TadAtThayer/MazeController/README.md

# MazeController
Arduino Shield for ES28 project
