TadAtThayer/MazeController/3d_models/LSF0102DQER.step

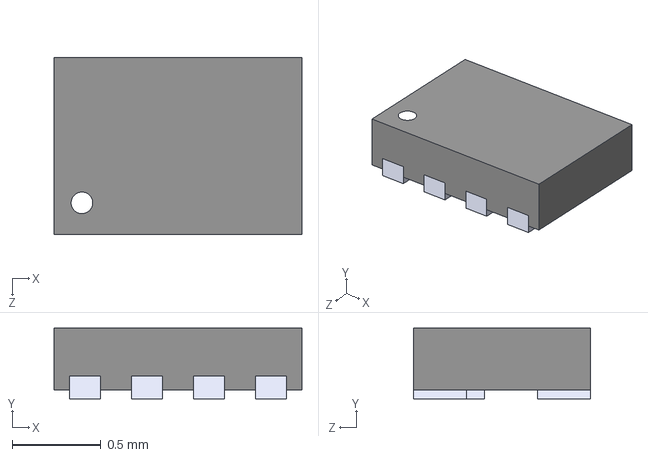
[picture p1: CAD file, 2023-10-11]
3d_models/LSF0102DQER.step
1.40 x 0.4 x 1.00 mm
