TadAtThayer/MazeController/ConnectorBoard/WiringHarness/WiringHarness.step

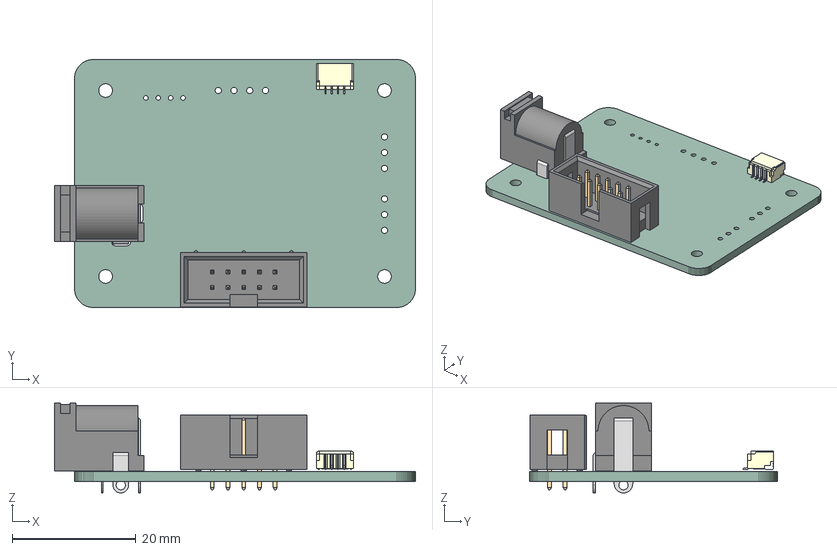
[picture p2: CAD file, 2023-10-23]
ConnectorBoard/WiringHarness/WiringHarness.step
58.2 x 40.0 x 14.5 mm
WiringHarness PCB
