TadAtThayer/MazeController/CUI_DEVICES_PJ-002A.step

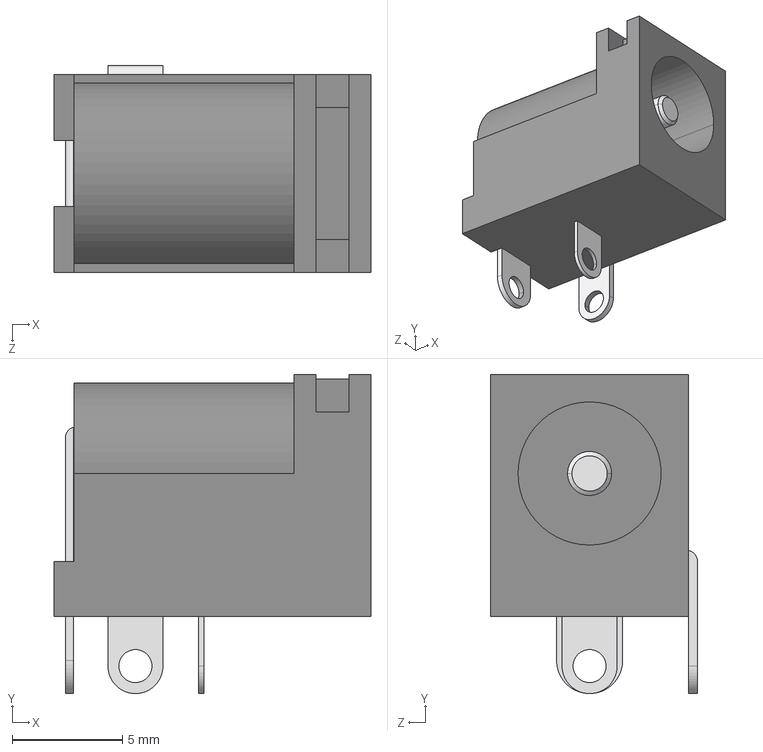
[picture p3: CAD file, 2023-10-09]
CUI_DEVICES_PJ-002A.step
14.4 x 14.5 x 9.40 mm
