TadAtThayer/MazeController/3d_models/COM-09032.step

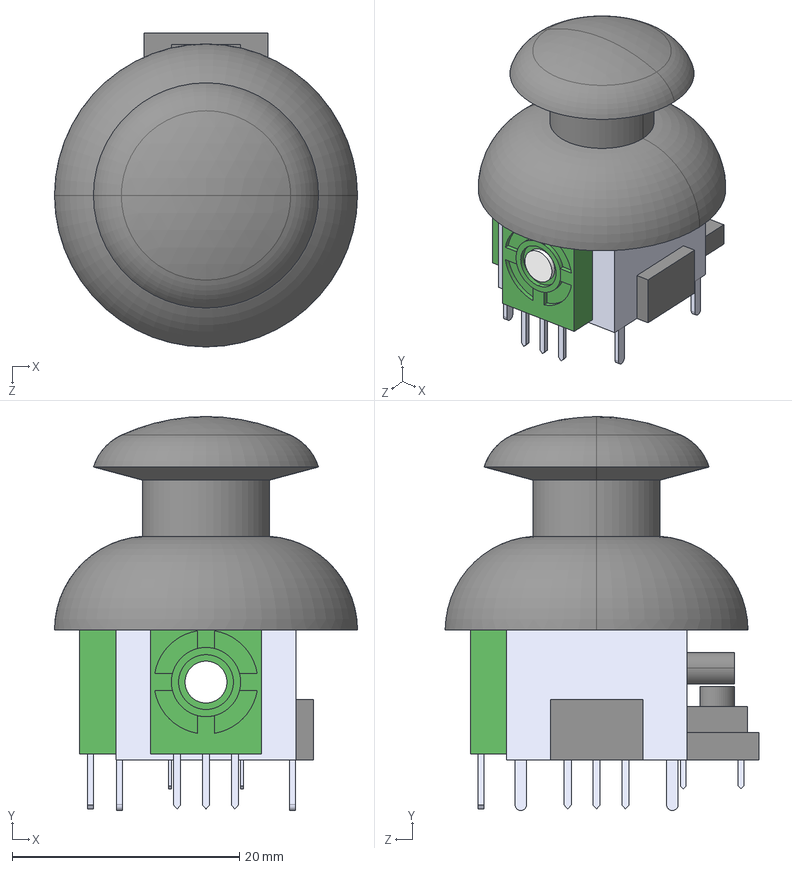
[picture p4: CAD file, 2023-10-11]
3d_models/COM-09032.step
26.7 x 34.7 x 27.6 mm
