TadAtThayer/MazeController/3d_models/c-5104340-01-b-3d.stp

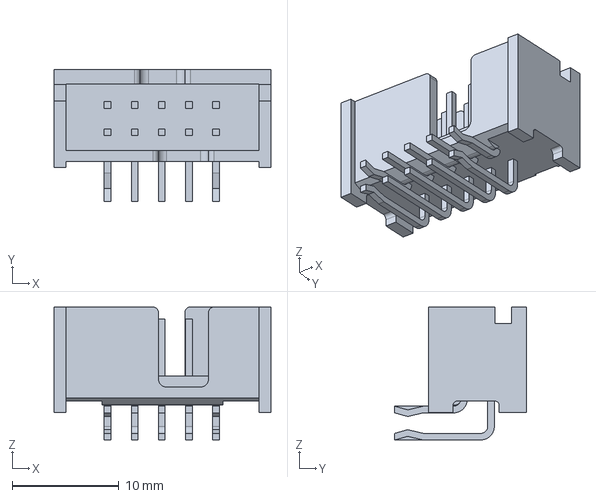
[picture p5: CAD file, 2023-10-10]
3d_models/c-5104340-01-b-3d.stp
20.3 x 12.3 x 12.5 mm
