TadAtThayer/MazeController/3d_models/61201021621.step

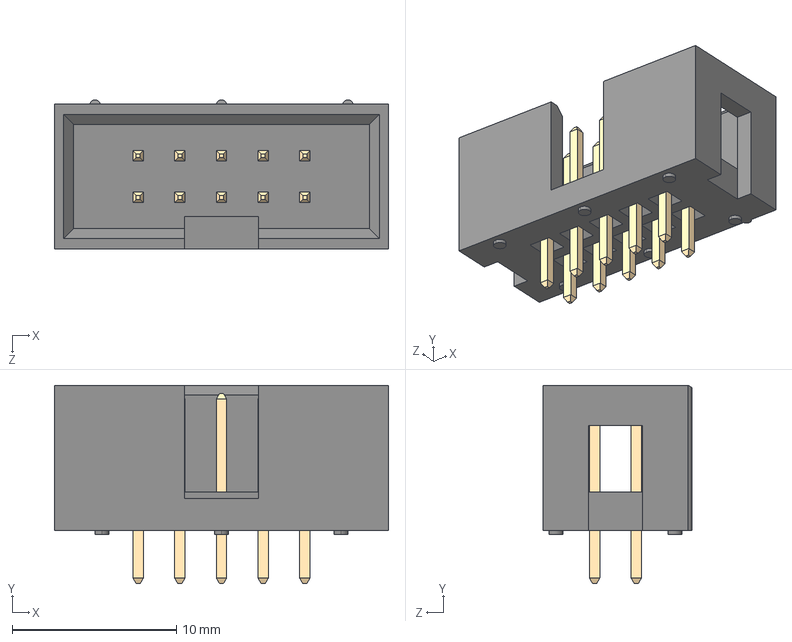
[picture p6: CAD file, 2023-10-09]
3d_models/61201021621.step
20.4 x 12.1 x 9.10 mm
