TadAtThayer/MazeController/(threads)

Thread 1 (2023-10-11):

Remove LDO for Arduino

tadtruex, 2023-10-11:
Remove the 5V LDO on the supply to the Arduino.

Replace with Schottky diode to mimic the power connector on Uno R3

Closed 2023-10-31.

Thread 3 (2023-10-11):

Features of Controller Board

tadtruex, 2023-10-11:
This is sort of a tracking list for what might go on the main board...

- [x] Joystick
- [x] Ribbon Cable connector
- [x] Accelerometer
- [ ] LED backpack (maybe on Wiring Harness instead)
- [x] Discrete LEDs
- [ ] Buzzer
- [x] Reset Button
- [x] Probe points for PWM checking

Add tracking issues for each of these (attached to Initial Public Release milestone) if they are included.

tadtruex, 2023-10-31:
Backpack moved to wiring harness.
Buzzer moved to the "what was I thinking" bucket.

Closed 2023-10-31.

Thread 4 (2023-10-16):

Fix Servo connections

tadtruex, 2023-10-16:
Mechanical samples are at 50mil pitch, should be 100mil.

Thread 5 (2023-10-16):

Add display to carrier board

tadtruex, 2023-10-16:
Add a display to either the carrier board or the joystick board.

Also add some LEDS...

If it ends up on the carrier board, may want to add another LDO to power it.

Closed 2023-10-31.

Thread 12 (2023-11-14):

Power supply issues

tadtruex, 2023-11-14:
Looks like we have some serious PS issues.

When the system powers up, it draws around 1 amp at 9V.  This is with 200uF of bulk cap added.  The initial transient is likely charging the caps, not really the motors.

The motors themselves seem to trip the benchtop supply around 1A @ 9V.  Motor voltage is set to ~5.5.

Possible solutions

- [x] Lots more DCap on the connector board.
- [ ] Slower Reset rise time (more cap on controller board)
- [ ] potentially add a power/reset controller to the controller board.

tadtruex, 2023-11-21:
Fixed as of effb6eae01d

Closed 2023-11-21.

Thread 13 (2023-11-14):

Move Green LED

tadtruex, 2023-11-14:
The green LED sits directly on top of the USB jack and shorts to it.

Move it outward or make it a SMD.

Closed 2023-11-21.

Thread 6 (2023-11-14):

Regulator bias network wrong

tadtruex, 2023-11-14:
The biasing network on the regulator is mostly upside down...

R3 and R4 are backward, and the pot really ought to be in the middle with the wiper connected to the reference pin.

Closed 2023-11-20.

Thread 16 (2023-11-29):

Additional power wires

tadtruex, 2023-11-29:

tadtruex, 2023-11-29:
This is optional as it is easy enough to bridge at the connector.

tadtruex, 2024-01-16:
Not fixing.  Switch to stepper made this moot.

Closed 2024-01-16.

Thread 17 (2023-12-27):

Change motors

tadtruex, 2023-12-27:
This will be a fairly invasive change...

It looks like standard stepper motors have some pretty inconvenient behaviors when loaded.  In particular, because they seem to implement a P type controller, when they get where they are going, they relax, causing the maze to fall, causing the motor to apply torque...  Oscillations.

Looking now at switching to small steppers (2 or possibly 3 if we need to drive both sides of the outer frame).  The cheapo ones come with a ULN2003 driver, which is really just 7 darlington pairs in a 16 pin DIP.  We'd rather present a higher level interface (step/direction might be ideal) so, tentatively thinking of parking an stm32011f6p6 on the board to present stepx, stepy, dirx, diry.

The board will should accomodate running a second y motor in reverse.

Closed 2024-01-24.

Thread 18 (2024-01-16):

10K Pot

tadtruex, 2024-01-16:

tadtruex, 2024-01-16:
Currently have a 1K pot on the adjustable reg.  Probably ought to make this 10K.  We plan to provide ~1.2A, so probably doesn't really matter, but kinda tacky to burn 25mW just on the reg.

Thread 19 (2024-01-16):

Wrong LDL regulator

tadtruex, 2024-01-16:
The 3.3V regulator has the wrong part number.  The part speced is adjustable.  The proper part number is

497-19548-1-ND (LDL212PV33R).

Same footprint.

Closed 2024-01-16.

Thread 20 (2024-01-17):

PCA9306 Footprint is ridiculous

tadtruex, 2024-01-17:
The footprint used (MSOP-8_3x3mm_P0.65mm) is way too big.  It works, but is really inefficient.

Thread 22 (2024-01-24):

Tracking Issue / Feature List

tadtruex, 2024-01-24:
What are we doing here?

We need either a step/direction interface or a PWM version.  PWM will need a way to reset zero since there is no feedback and we are really just mimicking servos.  Start with step/dir.

Minimum Requirements
- [ ] Step/Dir interface
- [ ] Manufacturing test
- [ ] I2C interface (mostly for ease of testing)

Enhanchements
- [ ] PWM
- [ ] I2C user interface

Future Board Mods if we do another spin
- [ ] Programmable POT for motor supply
- [ ] Heatsink on Motor Reg.
- [ ] Reset button
- [ ] Power Switch
- [ ] Isolate Motor supply from Arduino so we don't burn out too many Arduino regulators.

Thread 23 (2024-01-24):

Step/Dir interface

tadtruex, 2024-01-24:

tadtruex, 2024-01-24:
Dir = Low (Forward)
Dir = High (Reverse)
Step = Rising edge detect.

Steps can arrive at any rate, however the motor only responds at ~1Khz.

Thread 32 (2024-01-24):

Isolate Motor supply from Arduino so we don't burn out too many Arduino regulators.

tadtruex, 2024-01-24:

tadtruex, 2024-02-02:
Duplicate of #37

Closed 2024-02-02.

Thread 33 (2024-01-24):

Motor Saver

tadtruex, 2024-01-24:
Need to turn off the motor coils if the maze sits idle for too long.  They draw a decent amount of current (1.2A total) and the regulator gets pretty warm (hot) to the touch.

There "should" be enough static friction that we can just turn off the motor and stay put, but as a backup, we could pulse the coils periodically.

tadtruex, 2024-01-30:
Added a 10 second idle shutoff to each motor.  May need to revisit if we need to pulse the coils to provide some holding torque.

Commit 51164a1 contains the fix.

Closed 2024-01-30.

Thread 34 (2024-01-30):

Motor tracking

tadtruex, 2024-01-30:
The y motors aren't tracking each other correctly.  Seems to be repeatable with different motors, so either there is an even mix of fast and slow motors (and I got unlucky testing) or there is a code issue.

Thread 35 (2024-01-31):

5V I2C on JST connector is broken

tadtruex, 2024-01-31:
The solder jumpers on the back side were intended to allow us to run I2C over a QWIIC connector a 5V by default.

Unfortunately, this shorts the 3.3V regulator to 5V and runs the processor at 5 instead of 3.3.

JP1 must be cut on ALL builds of this rev.  Best recommendation is to ditch the QWIIC connector and its support circuitry entirely.

Thread 37 (2024-02-02):

Run motors directly from the brick

tadtruex, 2024-02-02:
On the wiring harness.  Power the motor regulator directly from the brick, not from Vsys.

This will prevent students from accidentally trying to power all three motors from the tiny little LDO on the Arduino.
