TadAtThayer/MazeController/ConnectorBoard/WiringHarness/WiringHarness.kicad_pcb

## KiCad design ConnectorBoard/WiringHarness/WiringHarness.kicad_pcb (2024-01-19)

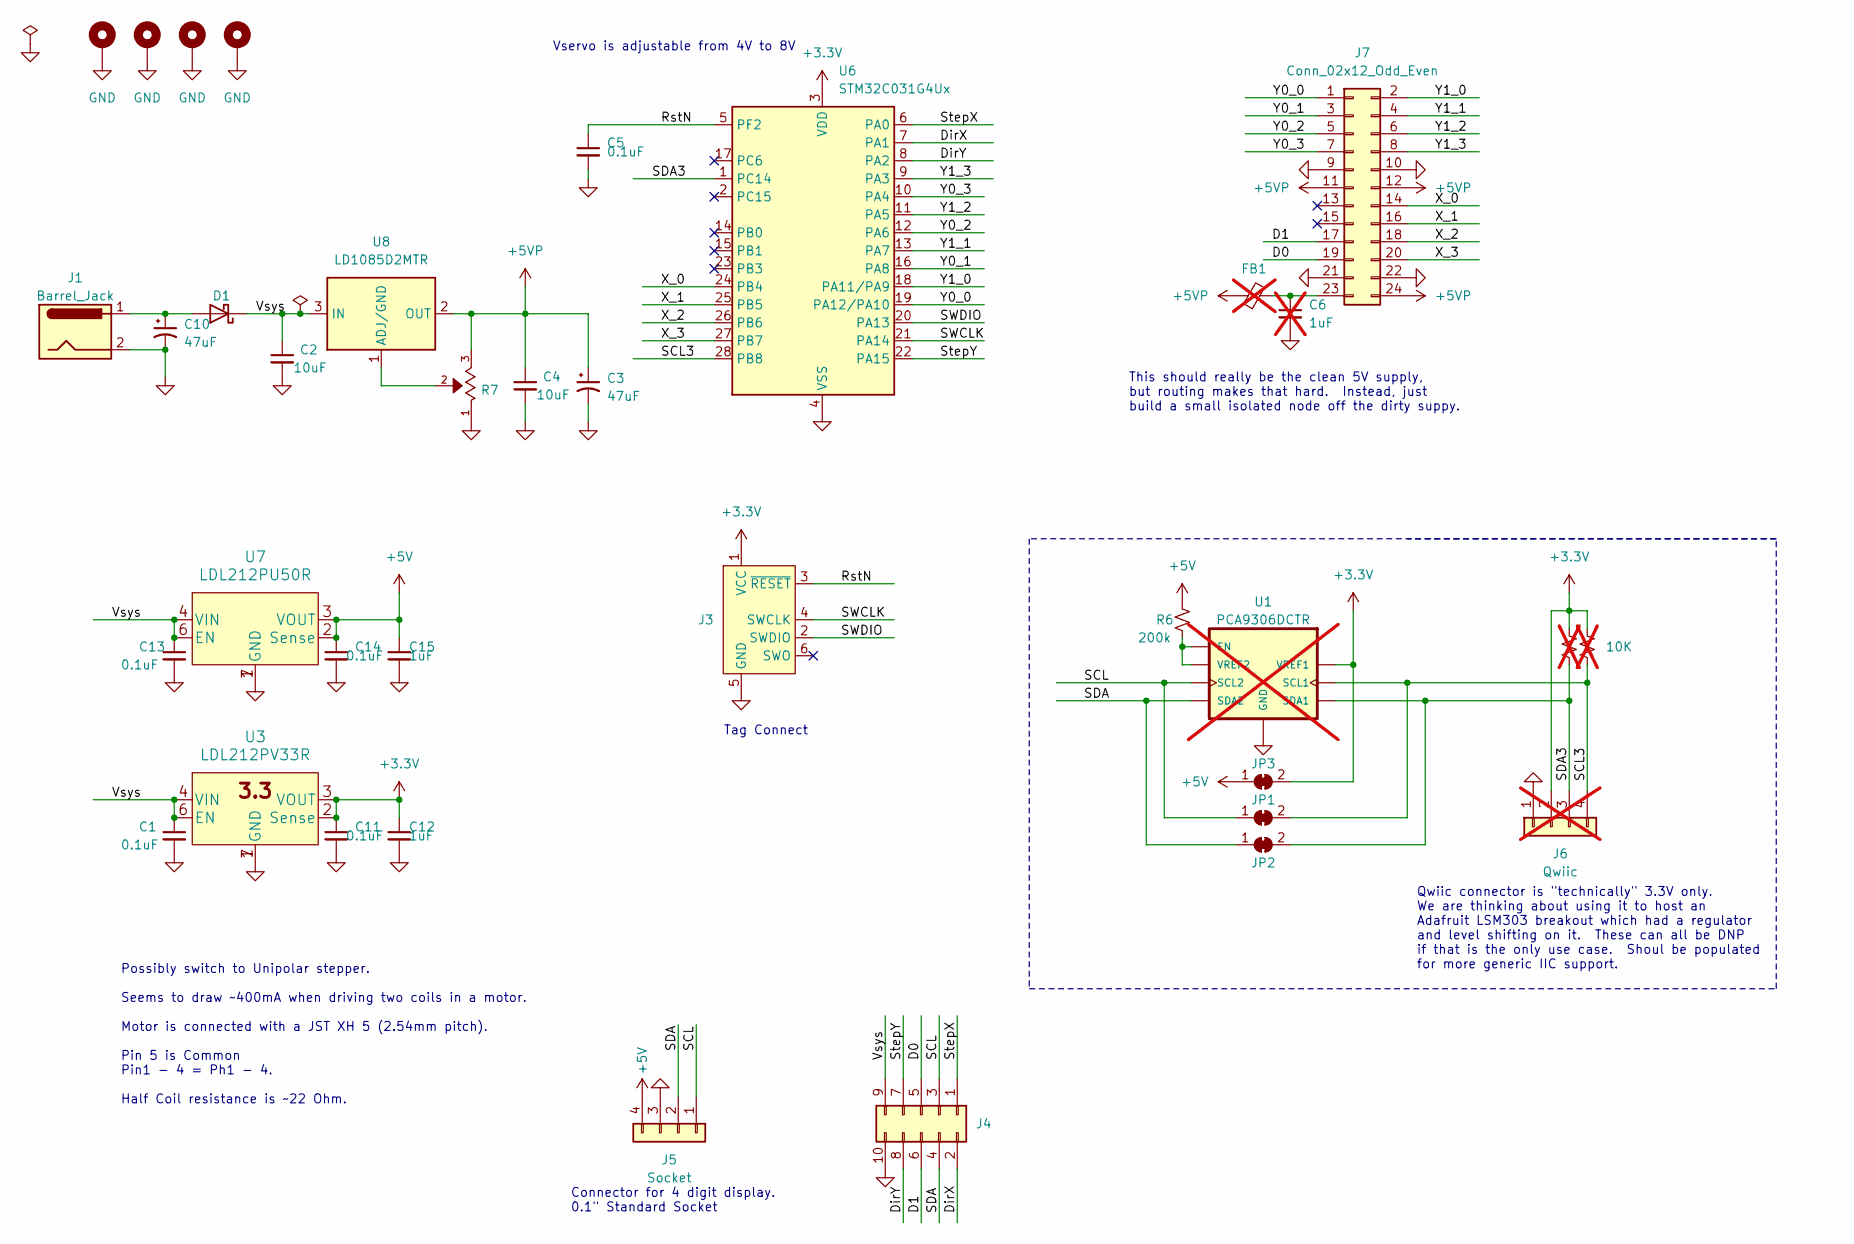
[picture p7: schematic WiringHarness.kicad_sch]

Parts:
C1, C5, C11, C13, C14: 0.1uF; C_0603_1608Metric; Digikey 1276-1861-1-ND
C2, C4: 10uF; C_0805_2012Metric; Digikey 490-10500-1-ND
C3, C10: 47uF; CP_Radial_D6.3mm_P2.50mm; Digikey 10-ECE-A1EKA470ICT-ND
C6: C_1U; C_0603_1608Metric; MPN CL10B105KA8NFNC; DigiKey PN 1276-1942-1-ND; not fitted
C12, C15: 1uF; C_0603_1608Metric; Digikey 1276-1861-1-ND
D1: D_Schottky; D_SMA; Digikey SK36A-LTPMSCT-ND
FB1: FB_120_100MHz; L_0603_1608Metric; DigiKey PN 490-16660-1-ND; not fitted
H1, H2, H3, H5: MountingHole_Pad; MountingHole_2.2mm_M2_Pad
J1: Barrel_Jack; BarrelJack_Horizontal; Digikey CP-002A-ND
J3: Conn_ARM_SWD_TagConnect_TC2030-NL; Tag-Connect_TC2030-IDC-NL_2x03_P1.27mm_Vertical
J4: Conn_02x05_Odd_Even; PinHeader_2x05_P2.54mm_Vertical; Digikey 732-2094-ND
J5: Socket; PinSocket_1x04_P2.54mm_Vertical; Digikey S7037-ND
J6: Qwiic; JST_SH_SM04B-SRSS-TB_1x04-1MP_P1.00mm_Horizontal; Digikey SM04B-SRSS-TB; not fitted
J7: Conn_02x12_Odd_Even; PinHeader_2x12_P2.54mm_Horizontal; Digikey 2057-PH2RA-24-UA-ND
JP1, JP2, JP3: SolderJumper_2_Bridged; SolderJumper-2_P1.3mm_Bridged_RoundedPad1.0x1.5mm
R1, R2: 10K; R_0603_1608Metric; Digikey RMCF0603FT10K0CT-ND; not fitted
R6: 200k; R_0603_1608Metric; Digikey RMCF0603FT200KCT-ND
R7: TC33X-2-102E; TRIM_TC33X-2-201E; Digikey TC33X-103ECT-ND
U1: PCA9306DCTR; MSOP-8_3x3mm_P0.65mm; Digikey 296-18509-1-ND; not fitted
U3: LDL212PV33R; LDL212_2x2mm_Pitch0.5mm; Digikey 497-19548-1-ND
U6: STM32C031G4Ux; QFN-28_4x4mm_P0.5mm; Digikey 497-STM32C031G6U6-ND
U7: LDL212PU50R; LDL212_3x3mm_Pitch0.95mm; Digikey 497-16897-1-ND
U8: LD1085D2MTR; TO-263-3_TabPin2; Digikey 497-3419-1-ND

Connections:
+3.3V: C11.1, C12.1, J3.1 (VCC), J6.2, JP3.2 (B), R1.1, R2.1, U1.2 (VREF1), U3.2 (Sense), U3.3 (VOUT), U6.3 (VDD)
+5V: C14.1, C15.1, J5.4, JP3.1 (A), R6.1, U7.2 (Sense), U7.3 (VOUT)
+5VP: C3.1, C4.1, FB1.1, J7.11, J7.12, J7.24, R7.3, U8.2 (OUT)
/D0: J4.5, J7.19
/D1: J4.6, J7.17
/DirX: J4.2, U6.7 (PA1)
/DirY: J4.8, U6.8 (PA2)
/RstN: C5.1, J3.3 (~RESET), U6.5 (PF2)
/SCL: J4.3, J5.1, JP1.1 (A), U1.6 (SCL2)
/SCL3: J6.4, JP1.2 (B), R1.2, U1.3 (SCL1), U6.28 (PB8)
/SDA: J4.4, J5.2, JP2.1 (A), U1.5 (SDA2)
/SDA3: J6.3, JP2.2 (B), R2.2, U1.4 (SDA1), U6.1 (PC14)
/SWCLK: J3.4 (SWCLK), U6.21 (PA14)
/SWDIO: J3.2 (SWDIO), U6.20 (PA13)
/StepX: J4.1, U6.6 (PA0)
/StepY: J4.7, U6.22 (PA15)
/Vsys: C1.1, C2.1, C13.1, D1.1 (K), J4.9, U3.4 (VIN), U3.6 (EN), U7.4 (VIN), U7.6 (EN), U8.3 (IN)
/X_0: J7.14, U6.24 (PB4)
/X_1: J7.16, U6.25 (PB5)
/X_2: J7.18, U6.26 (PB6)
/X_3: J7.20, U6.27 (PB7)
/Y0_0: J7.1, U6.19 (PA12/PA10)
/Y0_1: J7.3, U6.16 (PA8)
/Y0_2: J7.5, U6.12 (PA6)
/Y0_3: J7.7, U6.10 (PA4)
/Y1_0: J7.2, U6.18 (PA11/PA9)
/Y1_1: J7.4, U6.13 (PA7)
/Y1_2: J7.6, U6.11 (PA5)
/Y1_3: J7.8, U6.9 (PA3)
GND: C1.2, C2.2, C3.2, C4.2, C5.2, C6.2, C10.2, C11.2, C12.2, C13.2, C14.2, C15.2, H1.1, H2.1, H3.1, H5.1, J1.2, J3.5 (GND), J4.10, J5.3, J6.1, J7.9, J7.10, J7.21, J7.22, R7.1, U1.1 (GND), U3.1 (GND), U3.7 (GND), U6.4 (VSS), U7.1 (GND), U7.7 (GND)
unnamed: C10.1, D1.2 (A), J1.1
unnamed: C6.1, FB1.2, J7.23
unnamed: R6.2, U1.7 (VREF2), U1.8 (EN)
unnamed: R7.2, U8.1 (ADJ/GND)

Notes on the sheet:
This should really be the clean 5V supply, but routing makes that hard. Instead, just build a small isolated node off the dirty suppy.
Connector for 4 digit display. 0.1" Standard Socket
Vservo is adjustable from 4V to 8V
Possibly switch to Unipolar stepper. Seems to draw ~400mA when driving two coils in a motor. Motor is connected with a JST XH 5 (2.54mm pitch). Pin 5 is Common Pin1 - 4 = Ph1 - 4. Half Coil resistance is ~22 Ohm.
Qwiic connector is "technically" 3.3V only. We are thinking about using it to host an Adafruit LSM303 breakout which had a regulator and level shifting on it. These can all be DNP if that is the only use case. Shoul be populated for more generic IIC support.
Tag Connect

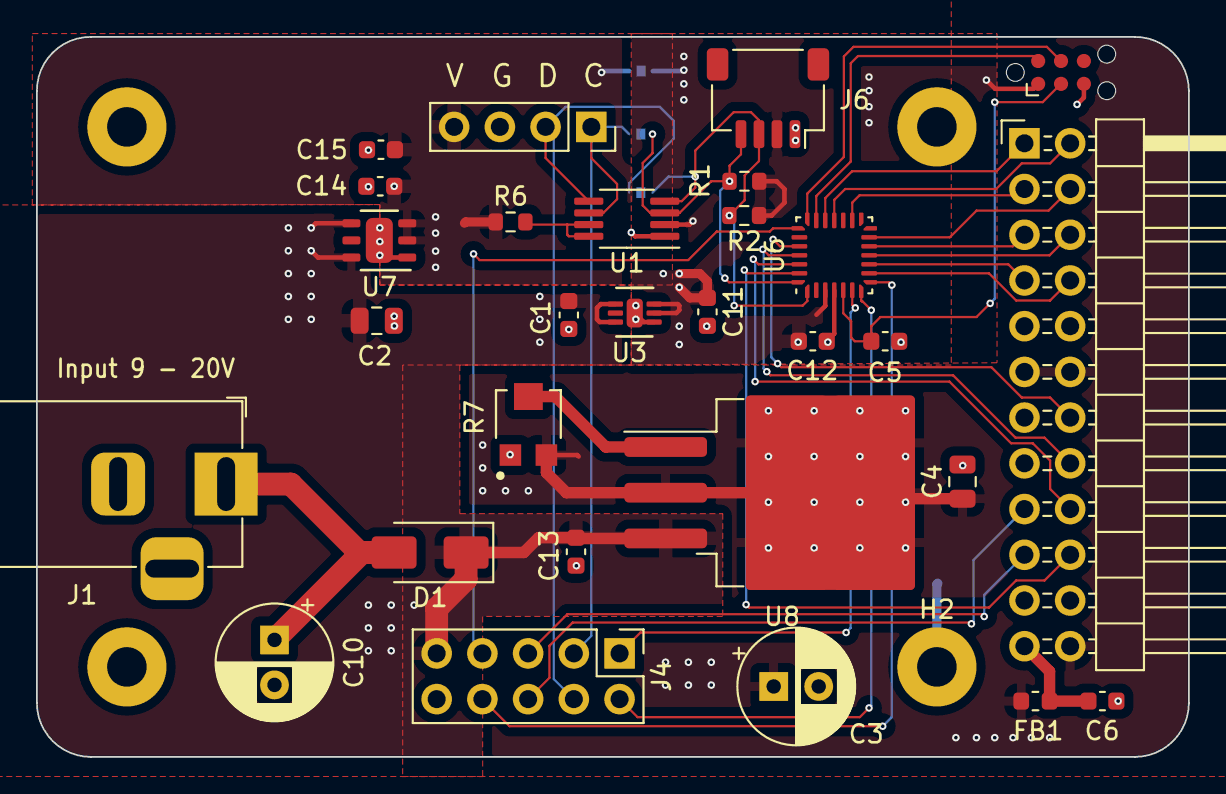
[picture p8: board WiringHarness.kicad_pcb from above]

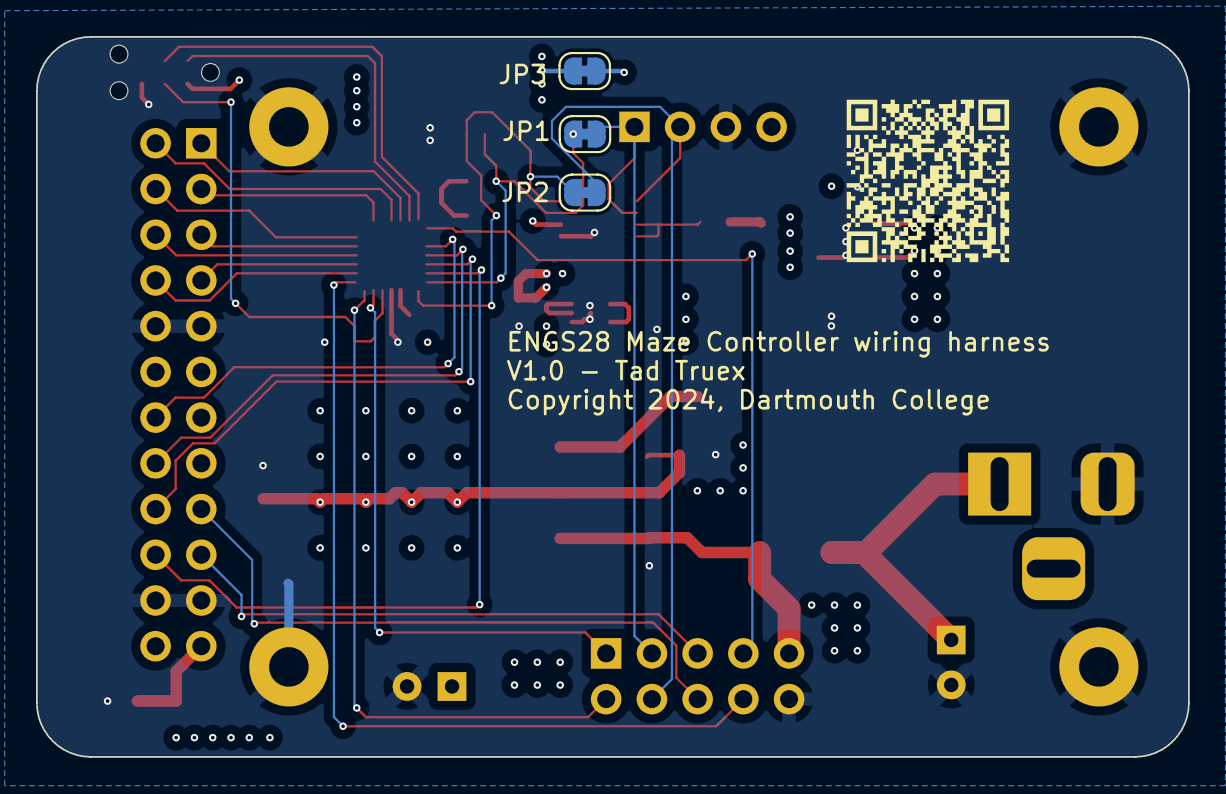
[picture p9: board WiringHarness.kicad_pcb from below]

Board: 4 copper layers, 64.0 x 40.0 mm, 36 parts (3 on the bottom side), 34 nets.
