TadAtThayer/MazeController/ControllerShield/ControllerShield.kicad_pcb

## KiCad design ControllerShield/ControllerShield.kicad_pcb (2024-01-05)

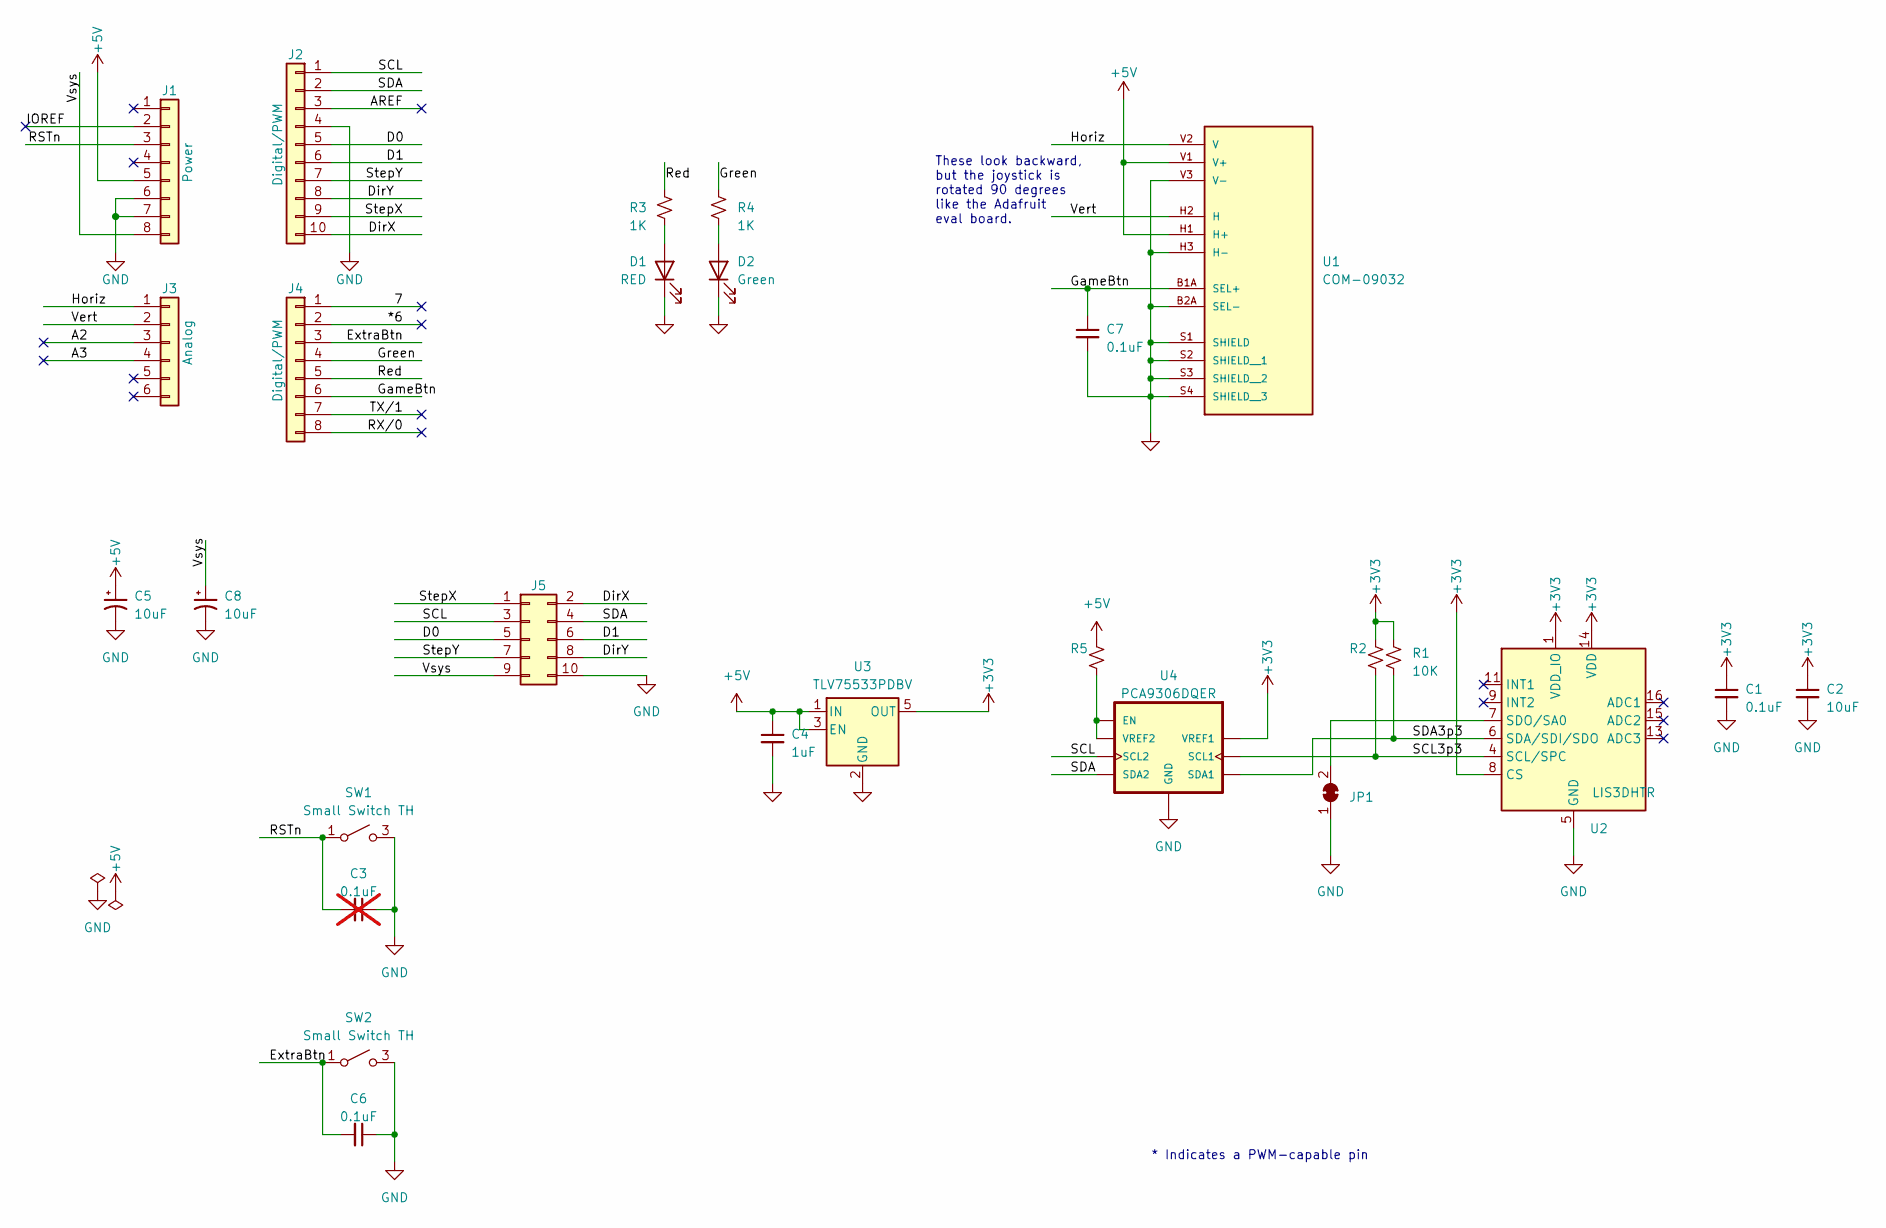
[picture p10: schematic ControllerShield.kicad_sch]

Parts:
C1, C6, C7: 0.1uF; C_0603_1608Metric; Digikey 1276-1000-1-ND
C2: 10uF; C_0603_1608Metric; Digikey 490-GRM188R61E106KA73JCT-ND
C3: 0.1uF; C_0603_1608Metric; Digikey 1276-1000-1-ND; not fitted
C4: 1uF; C_0603_1608Metric
C5, C8: 10uF; CP_Radial_D6.3mm_P2.50mm
D1: RED; LED_D5.0mm; Digikey 1125-1188-ND
D2: Green; LED_D5.0mm; Digikey 1125-1184-ND
J1: Power; PinSocket_1x08_P2.54mm_Vertical
J2: Digital/PWM; PinSocket_1x10_P2.54mm_Vertical
J3: Analog; PinSocket_1x06_P2.54mm_Vertical
J4: Digital/PWM; PinSocket_1x08_P2.54mm_Vertical
J5: Conn_02x05_Odd_Even; PinHeader_2x05_P2.54mm_Vertical; Digikey 732-2094-ND
JP1: SolderJumper_2_Bridged; SolderJumper-2_P1.3mm_Bridged_RoundedPad1.0x1.5mm
R1, R2: 10K; R_0603_1608Metric; Digikey RMCF0603FT10K0CT-ND
R3, R4: 1K; R_0603_1608Metric; Digikey RMCF0603FT1K00CT-ND
R5: 200K; R_0603_1608Metric; Digikey RMCF0603FT10K0CT-ND
SW1, SW2: Small Switch TH; SW4_1825910-B_TEC; Digikey 450-1650-ND
U1: COM-09032; XDCR_COM-09032
U2: LIS3DHTR; LGA-16_3x3mm_P0.5mm_LayoutBorder3x5y; Digikey 497-10613-1-ND
U3: TLV75533PDBV; SOT-23-5; Digikey 296-50411-1-ND
U4: PCA9306DQER; TSSOP-8_3x3mm_P0.65mm; DigiKey 296-18509-2-ND

Connections:
+3V3: C1.1, C2.1, R1.1, R2.1, U2.1 (VDD_IO), U2.8 (CS), U2.14 (VDD), U3.5 (OUT), U4.2 (VREF1)
+5V: C4.1, C5.1, J1.5, R5.1, U1.H1 (H+), U1.V1 (V+), U3.1 (IN), U3.3 (EN)
/7: J4.1
/*6: J4.2
/A2: J3.3
/A3: J3.4
/AREF: J2.3
/D0: J2.5, J5.5
/D1: J2.6, J5.6
/DirX: J2.10, J5.2
/DirY: J2.8, J5.8
/ExtraBtn: C6.2, J4.3, SW2.1 (A), SW2.2 (A)
/GameBtn: C7.1, J4.6, U1.B1A (SEL+)
/Green: J4.4, R4.1
/Horiz: J3.1, U1.V2 (V)
/IOREF: J1.2
/RSTn: C3.2, J1.3, SW1.1 (A), SW1.2 (A)
/RX/0: J4.8
/Red: J4.5, R3.1
/SCL: J2.1, J5.3, U4.6 (SCL2)
/SCL3p3: R2.2, U2.4 (SCL/SPC), U4.3 (SCL1)
/SDA: J2.2, J5.4, U4.5 (SDA2)
/SDA3p3: R1.2, U2.6 (SDA/SDI/SDO), U4.4 (SDA1)
/StepX: J2.9, J5.1
/StepY: J2.7, J5.7
/TX/1: J4.7
/Vert: J3.2, U1.H2 (H)
/Vsys: C8.1, J1.8, J5.9
GND: C1.2, C2.2, C3.1, C4.2, C5.2, C6.1, C7.2, C8.2, D1.1 (K), D2.1 (K), J1.6, J1.7, J2.4, J5.10, JP1.1 (A), SW1.3 (B), SW1.4 (B), SW2.3 (B), SW2.4 (B), U1.B2A (SEL-), U1.H3 (H-), U1.S1 (SHIELD), U1.S2 (SHIELD__1), U1.S3 (SHIELD__2), U1.S4 (SHIELD__3), U1.V3 (V-), U2.5 (GND), U2.10 (GND), U2.12 (GND), U3.2 (GND), U4.1 (GND)
unnamed: D1.2 (A), R3.2
unnamed: D2.2 (A), R4.2
unnamed: JP1.2 (B), U2.7 (SDO/SA0)
unnamed: R5.2, U4.7 (VREF2), U4.8 (EN)

Notes on the sheet:
These look backward, but the joystick is rotated 90 degrees like the Adafruit eval board.
* Indicates a PWM-capable pin

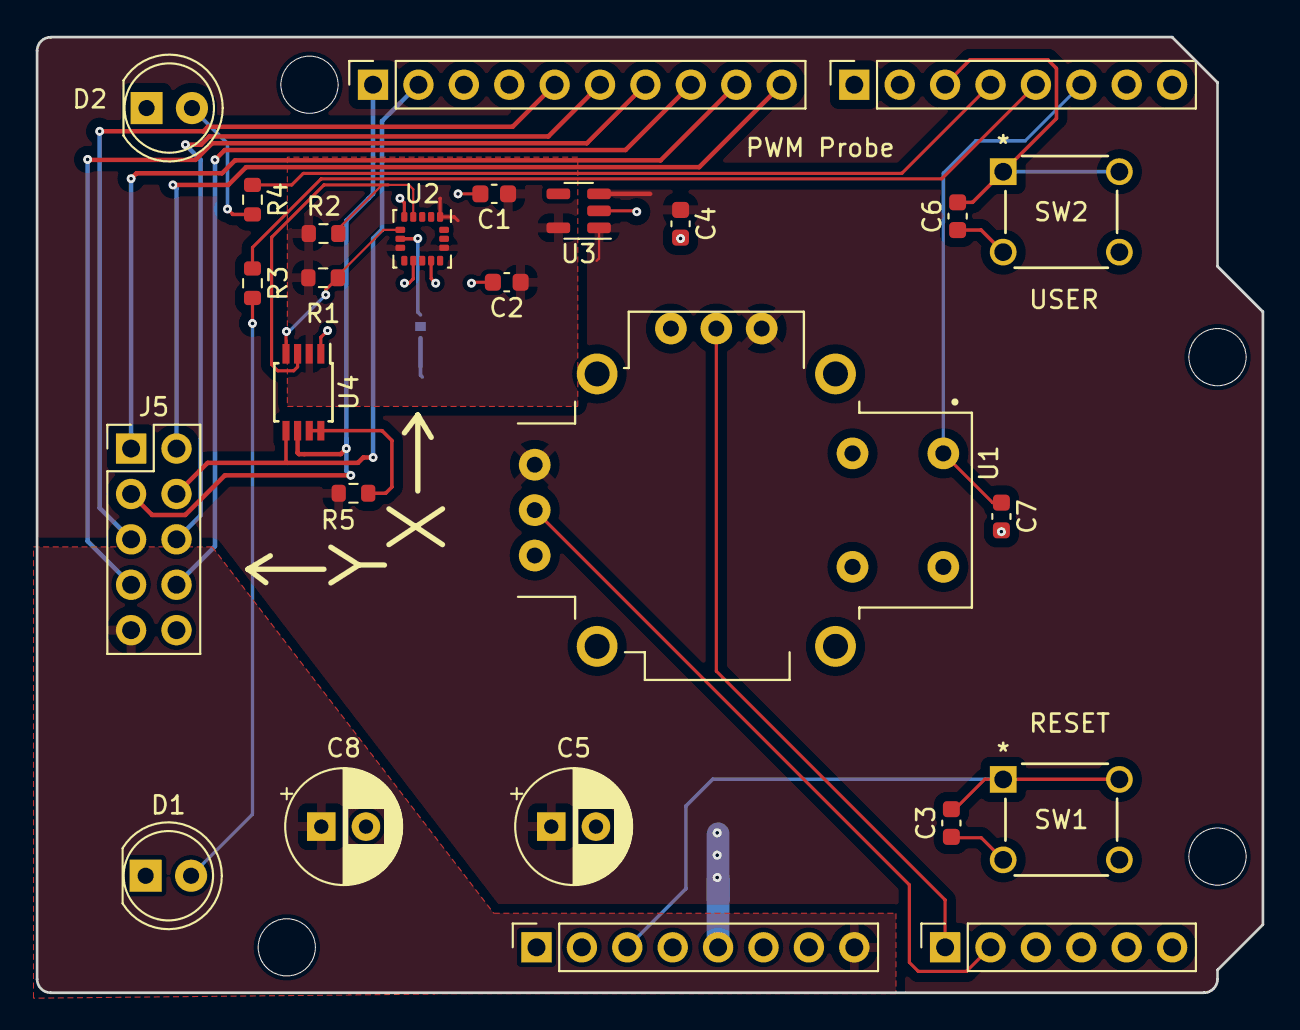
[picture p11: board ControllerShield.kicad_pcb from above]

Board: 2 copper layers, 68.6 x 53.5 mm, 31 parts (1 on the bottom side), 25 nets.

Other parts of the board:
MH1, MH2, MH3, MH4: MountingHole_3.2mm
