TadAtThayer/MazeController/Code/Workspace/StepperDevBoard/StepperDevBoard.ioc

Mcu.UserName=STM32C031C6Tx
PA0.GPIO_Label=StepX
PA0.Signal=S_TIM16_CH1
PA1.GPIO_Label=DirX
PA1.Signal=GPIO_Input
PA10.GPIO_Label=Y0_0
PA10.Signal=GPIO_Output
PA13.GPIO_Label=SWDIO
PA13.Signal=DEBUG_SWDIO
PA14-BOOT0.GPIO_Label=SWCLK
PA14-BOOT0.Signal=DEBUG_SWCLK
PA15.GPIO_Label=StepY
PA15.Signal=GPXTI15
PA2.GPIO_Label=DirY
PA2.Signal=GPIO_Input
PA3.GPIO_Label=Y1_3
PA3.Signal=GPIO_Output
PA4.GPIO_Label=Y0_3
PA4.Signal=GPIO_Output
PA5.GPIO_Label=Y1_2
PA5.Signal=GPIO_Output
PA6.GPIO_Label=Y0_2
PA6.Signal=GPIO_Output
PA7.GPIO_Label=Y1_1
PA7.Signal=GPIO_Output
PA8.GPIO_Label=Y0_1
PA8.Signal=GPIO_Output
PA9.GPIO_Label=Y1_0
PA9.Signal=GPIO_Output
PB0.GPIO_Label=ClockOut
PB0.Signal=GPIO_Output
PB4.GPIO_Label=X_0
PB4.Signal=GPIO_Output
PB5.GPIO_Label=X_1
PB5.Signal=GPIO_Output
PB6.GPIO_Label=X_2
PB6.Signal=GPIO_Output
PB7.GPIO_Label=X_3
PB7.Signal=GPIO_Output
PB8.Signal=I2C1_SCL
PB9.Signal=I2C1_SDA
PC13.GPIO_Label=User Button
PC13.Signal=GPXTI13
