TadAtThayer/MazeController/(commit log)

2023-10-06 start wiring harness
    [WiringHarness.kicad_pcb, WiringHarness.kicad_sch]
2023-10-09 Wiring harness probably OK
    [61201021621.step, CUI_DEVICES_PJ-002A.step, WiringHarness.kicad_pcb, WiringHarness.kicad_sch, WiringHarness.step]
2023-10-10 Add right angle ribbon cable to wiring harness
    [WiringHarness.kicad_pcb, WiringHarness.kicad_sch, WiringHarness.step, c-5104340-01-b-3d.stp]
2023-10-10 Rounded corners and version string
    [WiringHarness.kicad_pcb, WiringHarness.kicad_sch]
2023-10-10 Add QR code
    [WiringHarness-B_Cu.gbr, WiringHarness-B_Mask.gbr, WiringHarness-B_Paste.gbr, WiringHarness-B_Silkscreen.gbr, WiringHarness-Edge_Cuts.gbr, WiringHarness-F_Cu.gbr, WiringHarness-F_Mask.gbr, WiringHarness-F_Paste.gbr]
2023-10-11 start controller
    [COM-09032.step, ControllerShield.kicad_pcb, ControllerShield.kicad_sch, LSF0102DQER.step, WiringHarness.kicad_pcb]
2023-10-11 Tweak the connector board a bit. Rearrange X and Y. May do more depending on the other board.
    [61201021621.step, ControllerShield.kicad_pcb, ControllerShield.kicad_sch, WiringHarness.kicad_pcb, WiringHarness.kicad_sch, c-5104340-01-b-3d.stp]
2023-10-21 updates to connector
    [WiringHarness.kicad_pcb, WiringHarness.kicad_sch]
2023-10-23 decent candidate for rev 0.5wh
    [WiringHarness.kicad_pcb, WiringHarness.kicad_sch]
2023-10-23 Like 0.5 candidate
    [WiringHarness.kicad_pcb, WiringHarness.kicad_sch, WiringHarness.step]
2023-10-23 fix step file
    [WiringHarness.kicad_pcb]
2023-10-24 attempt to make the library directory relative.
    [WiringHarness.kicad_pcb]
2023-10-24 add pullups for 3.3 version of I2C bus.
    [WiringHarness.kicad_pcb, WiringHarness.kicad_sch]
2023-10-24 Not sure what changes, but it was minor...
    [ControllerShield.kicad_sch, WiringHarness.kicad_pcb, WiringHarness.kicad_sch]
2023-10-26 work on controller
    [ControllerShield.kicad_pcb, ControllerShield.kicad_sch]
2023-10-27 variable servo source
    [WiringHarness.kicad_pcb, WiringHarness.kicad_sch]
2023-10-30 Possible release candidate for Controller Board.
    [ControllerShield.kicad_pcb]
2023-10-31 Add switch to controller
    [ControllerShield.kicad_pcb, ControllerShield.kicad_sch]
2023-10-31 add probe points
    [ControllerShield.kicad_pcb, ControllerShield.kicad_sch]
2023-10-31 generate gerbers
    [WiringHarness-B_Cu.gbr, WiringHarness-B_Mask.gbr, WiringHarness-B_Paste.gbr, WiringHarness-B_Silkscreen.gbr, WiringHarness-Edge_Cuts.gbr, WiringHarness-F_Cu.gbr, WiringHarness-F_Mask.gbr, WiringHarness-F_Paste.gbr]
2023-10-31 Release candidate for controller board
    [ControllerShield-B_Cu.gbr, ControllerShield-B_Mask.gbr, ControllerShield-B_Paste.gbr, ControllerShield-B_Silkscreen.gbr, ControllerShield-Edge_Cuts.gbr, ControllerShield-F_Cu.gbr, ControllerShield-F_Mask.gbr, ControllerShield-F_Paste.gbr]
2023-11-16 initial rework and controller bom
    [WiringHarness.csv, WiringHarness.kicad_sch]
2023-11-20 Fix the bias network on the regulator.
    Close #6
    [WiringHarness.kicad_pcb, WiringHarness.kicad_sch]
2023-11-20 Work on #10.
    Need to decide if the leadless package is easier to deal with than a small BGA.
    Not obvious it is.
    [WiringHarness.kicad_pcb, WiringHarness.kicad_sch]
2023-11-21 signal caps at servo connectors
    [WiringHarness.kicad_pcb, WiringHarness.kicad_sch]
2023-11-21 Add QR code in preparation for next release
    Add Cap to
    5V
    Buttons
    Add level shifter.
    Close #7
    Close #9
    Close #11
    Close #14
    [ControllerShield.kicad_sch, WiringHarness.kicad_pcb]
2023-11-21 Change footprint for level shifter to something more reasonable.
    Add lots of cap to controller.
    Add level shifter to controller
    [ControllerShield.kicad_pcb, ControllerShield.kicad_sch, WiringHarness.kicad_pcb, WiringHarness.kicad_sch]
2023-11-21 Close #13
    [ControllerShield.kicad_pcb]
2023-11-21 update qr code and legend
    [ControllerShield.kicad_pcb, WiringHarness.kicad_pcb]
2023-11-21 Add a second switch to the controller board.
    Generate V0.9 gerbers with QRCode.
    [ControllerShield-B_Cu.gbr, ControllerShield-B_Mask.gbr, ControllerShield-B_Paste.gbr, ControllerShield-B_Silkscreen.gbr, ControllerShield-Edge_Cuts.gbr, ControllerShield-F_Cu.gbr, ControllerShield-F_Mask.gbr, ControllerShield-F_Paste.gbr]
2023-11-28 Hard to believe, but I had the resistors backward again on the regulator...
    [WiringHarness.kicad_pcb, WiringHarness.kicad_sch]
2023-11-29 add vendor id for level shifter
    [ControllerShield.kicad_sch]
2024-01-04 add some docs
    Convert to STM32C031 based stepper version.
    [WiringHarness.csv, WiringHarness.kicad_pcb, WiringHarness.kicad_sch]
2024-01-04 fully connected and drc clean. Need to examine copper pours
    [WiringHarness.kicad_pcb, WiringHarness.kicad_sch]
2024-01-04 cleanup the pours a bit
    [WiringHarness.kicad_pcb]
2024-01-05 Update controller shield to match the new driver.
    [ControllerShield.kicad_pcb, ControllerShield.kicad_sch]
2024-01-05 Gerbers for both board V1.0
    [ControllerShield-B_Cu.gbr, ControllerShield-B_Mask.gbr, ControllerShield-B_Paste.gbr, ControllerShield-B_Silkscreen.gbr, ControllerShield-Edge_Cuts.gbr, ControllerShield-F_Cu.gbr, ControllerShield-F_Mask.gbr, ControllerShield-F_Paste.gbr]
2024-01-05 fix vias
    [ControllerShield-B_Cu.gbr, ControllerShield-B_Mask.gbr, ControllerShield-B_Paste.gbr, ControllerShield-B_Silkscreen.gbr, ControllerShield-Edge_Cuts.gbr, ControllerShield-F_Cu.gbr, ControllerShield-F_Mask.gbr, ControllerShield-F_Paste.gbr]
2024-01-16 update names on dev board code
2024-01-16 match names to schematic
2024-01-16 turn on interrupts
2024-01-16 add i2c address
2024-01-16 Fix #19 - no artwork changes
    [WiringHarness.kicad_sch]
2024-01-18 clock stretching seems to kill i2c with arduino
2024-01-19 initial stepper fw on board
2024-01-19 switch to step models for many components
    [WiringHarness.csv, WiringHarness.kicad_pcb, WiringHarness.kicad_sch]
2024-01-19 bom changes
    [ControllerShield.csv, ControllerShield.kicad_sch]
2024-01-22 Switch move queu to contain a number of steps. This costs a bit in the interupt handler, but we're not running that fast, so we should be OK.
    This makes the queues much smaller.
2024-01-23 WIP (not currently working)
    Motor test process. Must be done with the motors uncaged.
    Switch to a peek mode on the queues to make it easier for the planner to tell
    if there is any pending motion.
2024-01-23 work on motor queue
2024-01-23 Motor Queue
2024-01-24 cleanup and bug hunt
    [MazeMain.cpp]
2024-01-30 Switch to half steps.
    Make the off time a register.
    Seems to fix the Y Y' offset issues.
    [MazeMain.cpp]
2024-01-31 add a DNP to the schematic. Step/Dir works OK
    [WiringHarness.kicad_sch]
2024-02-06 This is a bit of a CF.
    Working on self test for the driver board and noticed none of my new
    builds had functioning I2C. Flash an older working one with this code
    and it croaked.
    Going to do some git spelunking to find out why or at least when.
2024-02-07 add host address to 7 seg as i2c test
2024-02-08 Major cleanup/re-org. Working on driver for display backpack.
    Noticed that we can't access the backpack when the host (joystick) is attached.
    Worth pursuing...
2024-02-12 make calibrate a bit quicker
2024-02-14 signs of i2c life
2024-02-21 Update test program to work with motors installed
