TadAtThayer/MazeController/(notices)

Notices in the files:
ConnectorBoard/WiringHarness/WiringHarness.kicad_pcb:
Copyright 2024, Dartmouth College
